ducnguyen1224/HARD_WARE_SFAM/SensorNode_180808/BOM/SensorNode.xlsx

Sheet: SensorNode
DANH SÁCH LINH KIỆN MẠCH SENSOR
STT | Comment | Description | Designator | Số lượng trên mạch | Digikey Part Number hoặc Link mua hàng tại Việt Nam
1 | 0.1µF | CAP CER 0.1UF 10V X7R 0402 | C1, C2, C5, C6, C7, C8, C9, C10, C11, C12, C13, C14, C15, C16, C17, C18, C19, C20, C21, C22, C23, C24, C25, C26 | 24 | GRM155R61C104KA88D
2 | 10µF | CAP CER 10UF 16V X7R 0805 | C3, C4 | 2 | C2012X5R1C106K085AC
3 | Header 11 | MicroSD Card TF V3 Connector | J1 | 1 | http://banlinhkien.vn/goods-1914-socket-microsd-tf-v3-socket-the-nho-.html
4 | Ferrite Bead | FERRITE BEAD 42 OHM 0805 1LN | L1 | 1 | FBMJ2125HS420-T
5 | LedRed0603 | LED RED CLEAR 0603 SMD | LED1 | 1 | http://banlinhkien.vn/goods-2338-led-0603-mau-do-red-.html
6 | LedGreen0603 | LED GREEN CLEAR 0603 SMD | LED2 | 1 | http://banlinhkien.vn/goods-2945-led-0603-mau-xanh-la-green-.html
7 | Header 2 | Header, 2-Pin | P1, P10 | 2 | http://banlinhkien.vn/goods-987-con-2-kf301-2p-5-08mm-xanh-duong.html
8 | Header 4X2H | Header, 4-Pin, Dual row, Right Angle | P2 | 1 | http://banlinhkien.vn/goods-2686-jump-doi-duc-2-54mm-2x40p-thang-11mm.html
9 | Header 4H | TERM BLOCK PLUG 4POS STR 5.08MM | P3, P6 | 2 | http://banlinhkien.vn/goods-979-con-4-2edg5-08-4p-5-08mm-xanh-cong-.html
10 | BNC connector |  | P4, P5, P8, P9 | 4 | http://thegioiic.com/products/fm-bnc-v1
11 | Header 5 | TERM BLOCK PLUG 5POS STR 5.08MM (Ghép CON3 và CON2 lại) | P7 | 1 | http://banlinhkien.vn/goods-986-con-3-kf301-3p-5-08mm-xanh-duong.html http://banlinhkien.vn/goods-987-con-2-kf301-2p-5-08mm-xanh-duong.html
12 | Header 3 | Header, 3-Pin | P11 | 1 | http://banlinhkien.vn/goods-3526-jump-don-duc-led-1x40p.html
13 | Header 3X2 | Header, 3-Pin, Dual row | P12 | 1 | http://banlinhkien.vn/goods-2686-jump-doi-duc-2-54mm-2x40p-thang-11mm.html
14 | AO3401 | P-Channel MOSFET | Q1, Q2, Q3, Q4, Q5 | 5 | http://banlinhkien.vn/goods-5697-2n5551-sot23-trans-npn-0-6a-160v-100mhz-g1-.html
15 | 0 | RES SMD 0.0 OHM JUMPER 1/8W 0805 | R1, R2, R4, R13 | 4 | ERJ-6GEY0R00V
16 | 1.5k | RES SMD 1.5K OHM 1% 1/10W 0603 | R3 | 1 | ERA-3AEB152V
17 | 1k | RES SMD 1K OHM 1% 1/10W 0603 | R5, R14 | 2 | ERA-3AEB102V
18 | 10k | RES SMD 10K OHM 1% 1/10W 0603 | R6, R7, R8, R9, R10, R11, R12, R15, R18, R19, R20, R21, R22 | 13 | ERA-3AEB103V
19 | 187k | RES SMD 187K OHM 1% 1/10W 0603 | R16 | 1 | ERA-3AEB1873V
20 | 182k | RES SMD 182K OHM 1% 1/10W 0603 | R17 | 1 | ERA-3AEB1823V
21 | Button | Nút nhấn | RST1 | 1 | http://banlinhkien.vn/goods-1036-nut-nhan-2-chan-3x6x2-5mm-smd.html
22 | SMBJ7.0A | TVS DIODE 7V 12V DO214AA | TVS1 | 1 | SMBJ7.0A
23 | TPS7A7100 | IC REG LDO FIX/ADJ 1A 16QFN | U1 | 1 | TPS7A7100
24 | MK64FN1M0VLL12 | IC MCU 32BIT 1MB FLASH 100LQFP | U2 | 1 | MK64FN1M0VLL12
25 | TPL5010-Q1 | IC TIMER W/WATCHDOG 6SOT | U3 | 1 | TPL5010QDDCRQ1
26 | pH AFE | pH AFE | U4, U5, U6, U7 | 4 | Đây là mục EZO
27 | VZIGMOD1 | VNPT ZIGBEE MODULE V1 - No-PA | U8 | 1 | https://www.alibaba.com/product-detail/CC2538-CC2592-zigbee-radio-module_60620989315.html
28 | Antenna | 2.4GHz Antenna |  | 1 | http://banlinhkien.vn/goods-8260-anten-wifi-2-4g-2dbi-ipex-aw-2-4g-2ip.html

Sheet: banlinhkien.vn
STT | Link | Số lượng
1 | http://banlinhkien.vn/goods-2338-led-0603-mau-do-red-.html | 5
2 | http://banlinhkien.vn/goods-2945-led-0603-mau-xanh-la-green-.html | 5
3 | http://banlinhkien.vn/goods-1720-jump-doi-duc-1-27mm-2x40p-thang.html | 1
4 | http://banlinhkien.vn/goods-979-con-4-2edg5-08-4p-5-08mm-xanh-cong-.html | 5
5 | http://banlinhkien.vn/goods-986-con-3-kf301-3p-5-08mm-xanh-duong.html | 10
6 | http://banlinhkien.vn/goods-987-con-2-kf301-2p-5-08mm-xanh-duong.html | 10
7 | http://banlinhkien.vn/goods-3526-jump-don-duc-led-1x40p.html | 2
8 | http://banlinhkien.vn/goods-5697-2n5551-sot23-trans-npn-0-6a-160v-100mhz-g1-.html | 20
9 | http://banlinhkien.vn/goods-5061-module-wifi-esp8266-esp-12e.html | 2
10 | http://banlinhkien.vn/goods-7501-nut-nhan-4-chan-6x6x5mm-smd.html | 5
