ducnguyen1224/HARD_WARE_SFAM/Sfarm _GW/BOM/GWSfarm.xlsx

Designator | Description | Manufacturer | Manufacturer Part Number | Quantity/Product | Link
BT200, BT201 | Nút Nhấn 2 Chân 3x6x2.5MM SMD |  |  | 10 | http://banlinhkien.vn/goods-1036-nut-nhan-2-chan-3x6x2-5mm-smd.html
C10, C100, C101, C104, C105, C115, C200, C201, C202, C203, C205, C206, C208, C209, C210, C211, C212, C213, C400 | CAP CER 0.1UF 10V X7R 0402 | Taiyo Yuden | LMK105B7104KVHF | 18 | https://www.digikey.com/product-detail/en/taiyo-yuden/LMK105B7104KVHF/587-3769-1-ND/4811239
C102, C103 | CAP CER 10UF 16V X7R 0805 | Taiyo Yuden | EMK212BB7106MG-T | 2 | https://www.digikey.com/product-detail/en/taiyo-yuden/EMK212BB7106MG-T/587-3319-1-ND/4157364
C106, C114 | CAP CER 2.2UF 16V X5R 0402 | Taiyo Yuden | EMK105ABJ225MV-F | 2 | https://www.digikey.com/product-detail/en/taiyo-yuden/EMK105ABJ225MV-F/587-3302-1-ND/4157199
C107, C108, C109, C110, C111, C112 | CAP CER 22UF 16V X5R 0805 | Taiyo Yuden | EMK212BBJ226MG-T | 6 | https://www.digikey.com/product-detail/en/taiyo-yuden/EMK212BBJ226MG-T/587-3239-1-ND/3660095
C113 | CAP TANT 150UF 10V 10% 2917 | AVX Corporation | TPSD157K010R0085 | 1 | https://www.digikey.com/product-detail/en/avx-corporation/TPSD157K010R0085/478-9158-1-ND/4562023
C204, C207 | CAP CER 12PF 50V C0G/NP0 0402 | Murata Electronics North America | GRM1555C1H120GA01D | 2 | https://www.digikey.com/product-detail/en/murata-electronics-north-america/GRM1555C1H120GA01D/490-6197-1-ND/3845394
D100 | TVS DIODE 7V 12V DO214AA | Littelfuse Inc | SMBJ7.0A | 1 | https://www.digikey.com/product-detail/en/littelfuse-inc/SMBJ7.0A/SMBJ7.0ALFDKR-ND/741878
L101 | Fixed Inductors 1uH 20% 11A 11.9mOhms AEC-Q200 | Coilcraft | XFL4020-102MEB | 1 | https://www.mouser.vn/ProductDetail/Coilcraft/XFL4020-102MEB
P100 | CON 2 KF301-2P 5.08MM Xanh Dương |  |  | 1 | http://banlinhkien.vn/goods-987-con-2-kf301-2p-5-08mm-xanh-duong.html
P200 | Jump Đôi Đực 2.54MM 2x40P Thẳng 11MM |  |  | 1 | http://banlinhkien.vn/goods-2686-jump-doi-duc-2-54mm-2x40p-thang-11mm.html
P201 | Socket MicroSD TF V3 (Socket Thẻ Nhớ) |  |  | 1 | http://banlinhkien.vn/goods-1914-socket-microsd-tf-v3-socket-the-nho-.html
P400, P401 | Jump Đôi Đực 2.54MM 2x40P Cong |  |  | 2 | http://banlinhkien.vn/goods-5385-jump-doi-duc-2-54mm-2x40p-cong.html
P402, P404 | Header, 3-Pin |  |  | 2 | http://banlinhkien.vn/goods-903-jump-don-duc-2-54mm-1x40p-thang-11mm.html
PWR | LED RED CLEAR 0603 SMD | Everlight Electronics Co Ltd | QTLP600C7TR | 1 | http://banlinhkien.vn/goods-2338-led-0603-mau-do-red-.html
Q400 | MOSFET P-1CH 4A 30V (A19T) |  | AO3401 | 1 | http://banlinhkien.vn/goods-5697-ao3401-sot23-3-mosfet-p-1ch-4a-30v-a19t-.html
R100, L100, L102 | RES SMD 0.0 OHM JUMPER 1/8W 0805 | Panasonic Electronic Components | ERJ-6GEY0R00V | 3 | https://www.digikey.com/product-detail/en/panasonic-electronic-components/ERJ-6GEY0R00V/P0.0ADKR-ND/577786
R101 | RES SMD 1.5K OHM 1% 1/10W 0603 | Panasonic Electronic Components | ERJ-3EKF1501V | 1 | https://www.digikey.com/product-detail/en/panasonic-electronic-components/ERJ-3EKF1501V/P1.50KHDKR-ND/576003
R103, R208 | RES SMD 1K OHM 1% 1/10W 0603 | Panasonic Electronic Components | ERJ-3EKF1001V | 2 | https://www.digikey.com/product-detail/en/panasonic-electronic-components/ERJ-3EKF1001V/P1.00KHDKR-ND/575914
R104 | RES SMD 1M OHM 1% 1/10W 0402 | Yageo | RC0402FR-071ML | 1 | https://www.digikey.com/product-detail/en/yageo/RC0402FR-071ML/311-1.00MLRDKR-ND/732409
R106 | RES SMD 1M OHM 1% 1/10W 0603 | Panasonic Electronic Components | RC0603FR-071ML | 1 | https://www.digikey.com/product-detail/en/yageo/RC0603FR-071ML/311-1.00MHRDKR-ND/732738
R107 | RES SMD 150K OHM 1% 1/10W 0402 | Panasonic Electronic Components | ERJ-2RKF1503X | 1 | https://www.digikey.com/product-detail/en/panasonic-electronic-components/ERJ-2RKF1503X/P150KLDKR-ND/575521
R108, R109 | RES SMD 47K OHM 1% 1/10W 0603 | Panasonic Electronic Components | ERJ-3EKF4702V | 2 | https://www.digikey.com/product-detail/en/panasonic-electronic-components/ERJ-3EKF4702V/P47.0KHDKR-ND/1747145
R200, R202, R209, R400, R401, R404 | RES SMD 10K OHM 1% 1/10W 0603 | Panasonic Electronic Components | ERJ-3EKF1002V | 6 | https://www.digikey.com/product-detail/en/panasonic-electronic-components/ERJ-3EKF1002V/P10.0KHDKR-ND/575915
R207, R212 | RES SMD 0.0OHM JUMPER 1/10W 0603 | Panasonic Electronic Components | ERJ-3GEY0R00V | 2 | https://www.digikey.com/product-detail/en/panasonic-electronic-components/ERJ-3GEY0R00V/P0.0GDKR-ND/577612
R210 | RES SMD 33K OHM 0.1% 1/10W 0603 | Yageo | RT0603BRD0733KL | 1 | https://www.digikey.com/product-detail/en/yageo/RT0603BRD0733KL/YAG1640DKR-ND/5140017
STT | LED GREEN CLEAR 0603 SMD | Everlight Electronics Co Ltd | QTLP601C4TR | 1 | http://banlinhkien.vn/goods-2945-led-0603-mau-xanh-la-green-.html
U100 | IC REG LDO FIX/ADJ 1A 16QFN | Texas Instruments | TPS7A7100RGTR | 1 | https://www.digikey.com/product-detail/en/texas-instruments/TPS7A7100RGTR/296-40978-6-ND/5180088
U101 | IC REG BUCK BST ADJ 3.5A | Texas Instruments | TPS63020QDSJRQ1 | 1 | https://www.digikey.com/product-detail/en/texas-instruments/TPS63020QDSJRQ1/296-43286-6-ND/5801594
U200 | IC MCU 32BIT 1MB FLASH 100LQFP | NXP USA Inc. | MK64FN1M0VLL12 | 1 | https://www.digikey.com/product-detail/en/nxp-usa-inc/MK64FN1M0VLL12/MK64FN1M0VLL12-ND/4462052
U202 | IC TIMER W/WATCHDOG 6SOT | Texas Instruments | TPL5010QDDCRQ1 | 1 | https://www.digikey.com/product-detail/en/texas-instruments/TPL5010QDDCRQ1/296-44963-6-ND/6235576
Y200 | CRYSTAL 32.7680KHZ 12.5PF SMD | Abracon LLC | ABS07-32.768KHZ-T | 1 | https://www.digikey.com/product-detail/en/abracon-llc/ABS07-32.768KHZ-T/535-9542-6-ND/1624263
U400 | Jump Đôi Cái 1.27MM 2x40P Dán |  |  | 1 | http://banlinhkien.vn/goods-1724-jump-doi-cai-1-27mm-2x40p-dan.html
U8 | Zigbee module |  |  | 1 | https://www.alibaba.com/product-detail/CC2538-CC2592-zigbee-radio-module_60620989315.html
 | Module 3G | SIMCOM | sim 5360e | 1 | https://item.taobao.com/item.htm?id=39659918639&ns=1&abbucket=11 (https://item.taobao.com/item.htm?spm=a230r.1.14.33.269431b1O0DzLh&id=39659918639&ns=1&abbucket=11)
 | Dây nối dài anten SMA đực - Ipex |  |  | 1 | http://banlinhkien.vn/goods-1825-day-keo-dai-anten-sim-sma-cai-u-fl-mmcx-sma-rf-sma-.html
 | Anten 3G SMA cái |  |  | 1 | http://banlinhkien.vn/goods-1827-anten-sim-sma-duc-chan-cong.html
