ducnguyen1224/HARD_WARE_SFAM/WiFi_Shield_180808/WiFi_Shield_180808/BOM/WiFi_Shield.xlsx

Comment | Description | Designator | Số lượng trên mạch | Digikey Part Number hoặc Link mua tại Việt Nam
0.1µF | CAP CER 0.1UF 10V X7R 0402 | C1, C3, C4 | 3 | GRM155R61C104KA88D
10µF | CAP CER 10UF 10V X5R 0603 | C2 | 1 | C2012X5R1C106K085AC
Header 4 | Header, 4-Pin | P2 | 1 | http://banlinhkien.vn/goods-903-jump-don-duc-2-54mm-1x40p-thang-11mm.html
Header 3 | Header, 3-Pin | P3 | 1
MHDR2X10 | Header, 10-Pin, Dual row | P4 | 1 | http://banlinhkien.vn/goods-1721-jump-doi-duc-1-27mm-2x40p-dan.html
AO3401 | P-Channel MOSFET | Q1 | 1 | http://banlinhkien.vn/goods-5697-2n5551-sot23-trans-npn-0-6a-160v-100mhz-g1-.html
10k | RES SMD 10K OHM 1% 1/16W 0402 | R1, R2, R3, R4, R5, R6, R8, R10 | 8 | ERA-3AEB103V
RS-282G05A3-SM RT | SWITCH TACTILE SPST-NO 0.05A 12V | S1 | 1 | http://banlinhkien.vn/goods-1036-nut-nhan-2-chan-3x6x2-5mm-smd.html
PTS645SL70SMTR92LFS | SWITCH TACTILE SPST-NO 0.05A 12V | SW1 | 1 | PTS645SL70SMTR92LFS
ESP-12e | ESP8266 SMT MODULE | U1 | 1 | http://thegioiic.com/products/esp-12f-esp8266-mach-thu-phat-wifi
