ducnguyen1224/HARD_WARE_SFAM/SensorNode_180808/PDF/Schematic Prints.PDF

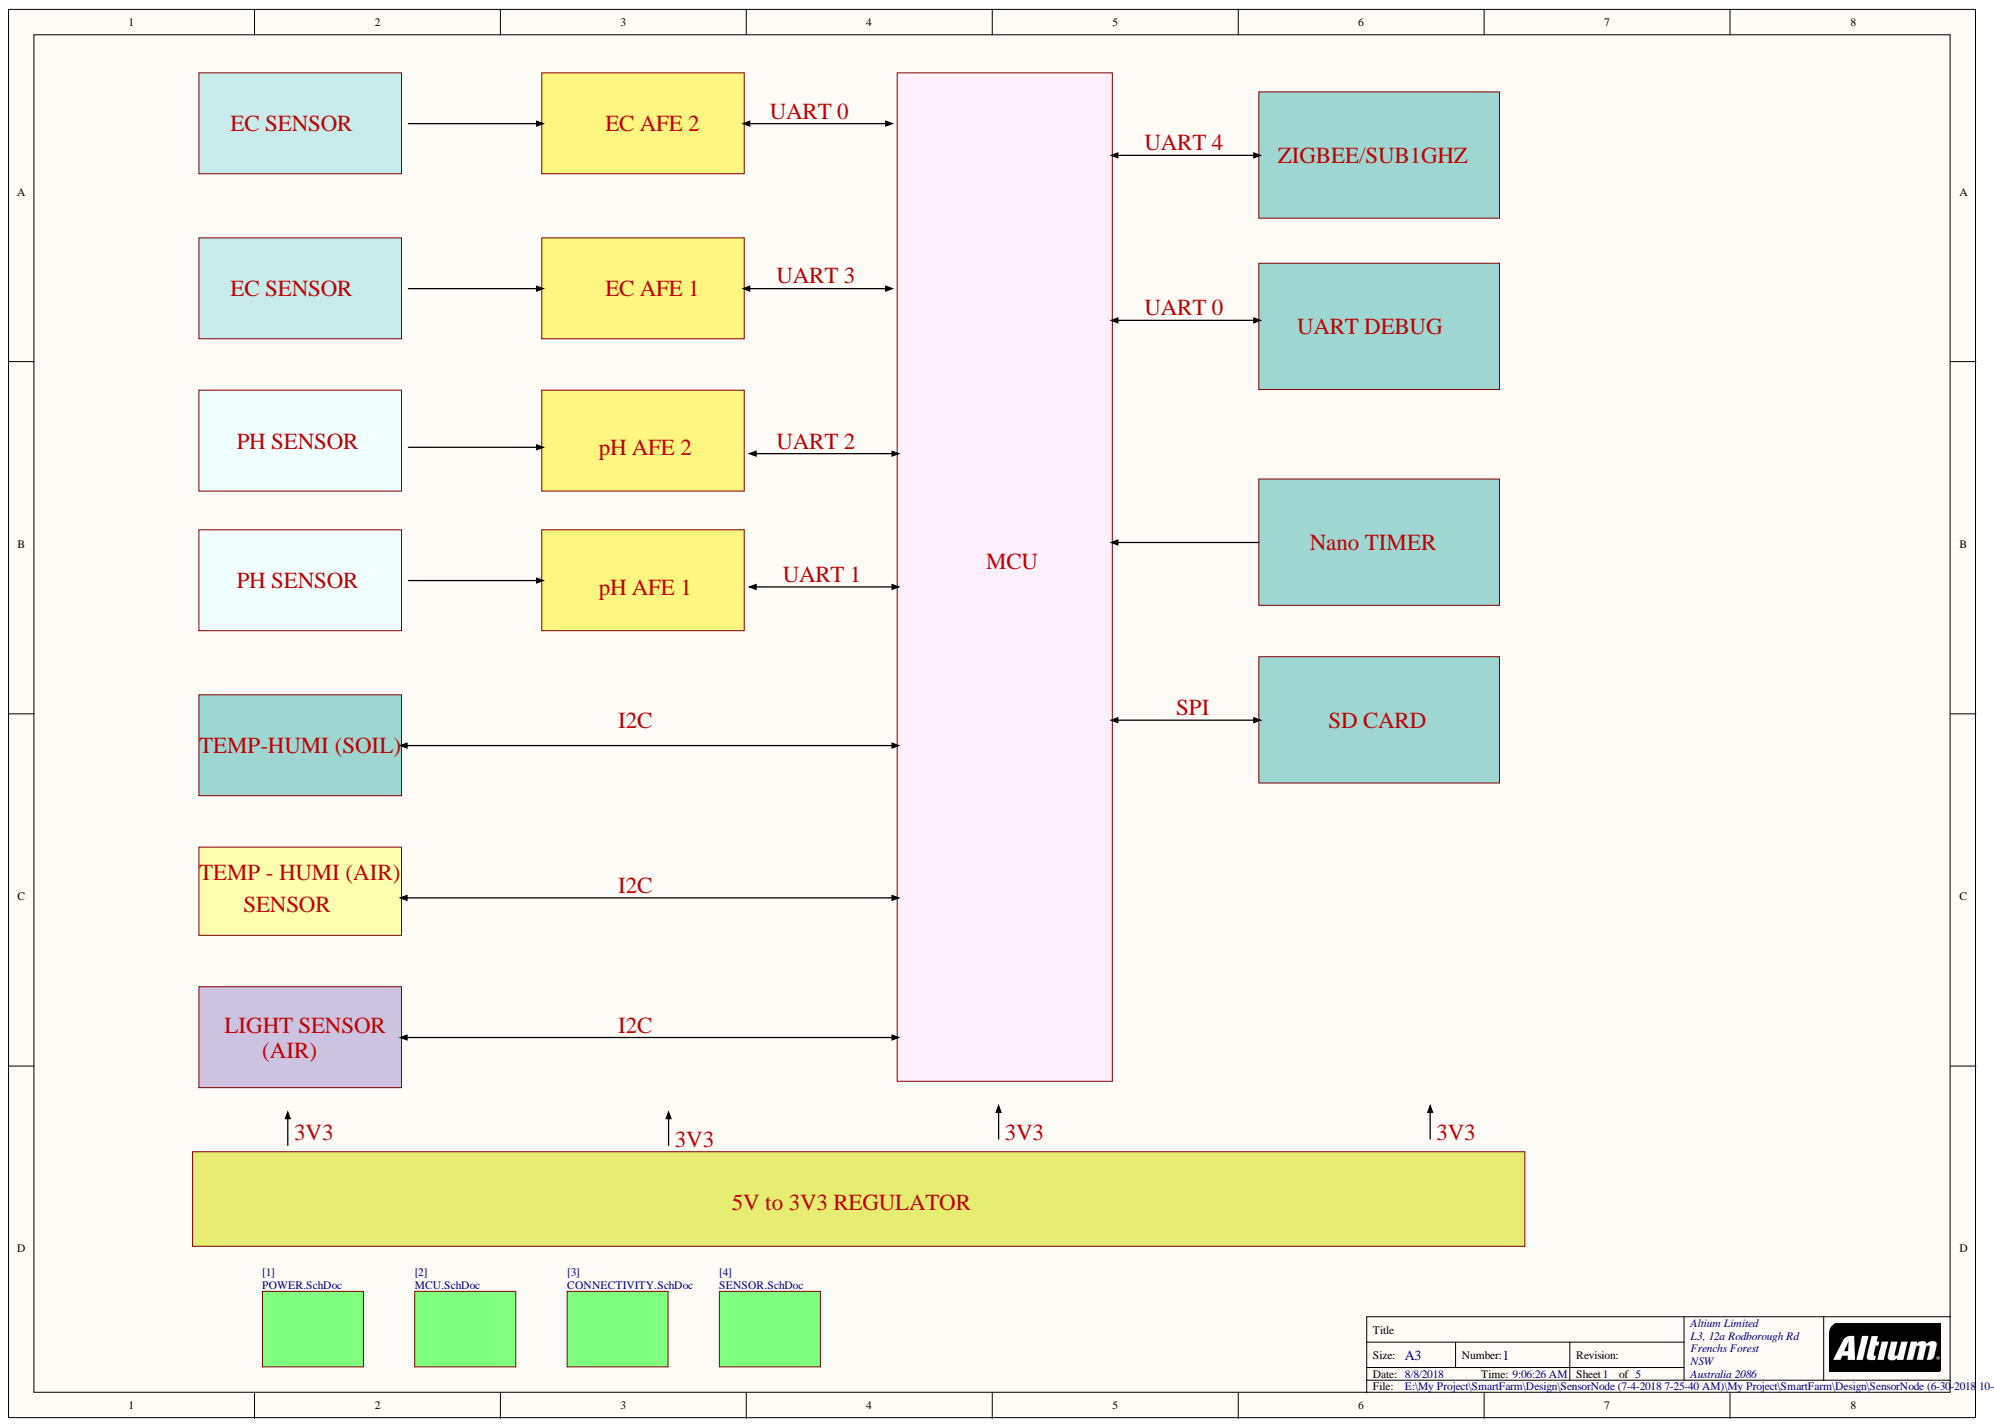
[picture p1: page 1]

pH AFE 2 PH SENSOR

Title | Altium Limited L3, 12a Rodborough Rd Frenchs Forest NSW Australia 2086

Size: A3 | Number: | Revision:

Date: 8/8/2018 Time: 9:06:26 AM | | Sheet of 5

E:\My Project\SmartFarm\Design\SensorNode (7-4-2018 7-25-40 AM)\My Project\SmartFarm\Design\SensorNode (6-30-2018 10-46-34 PM)\BLOCK DIAGRAM.SchDoc

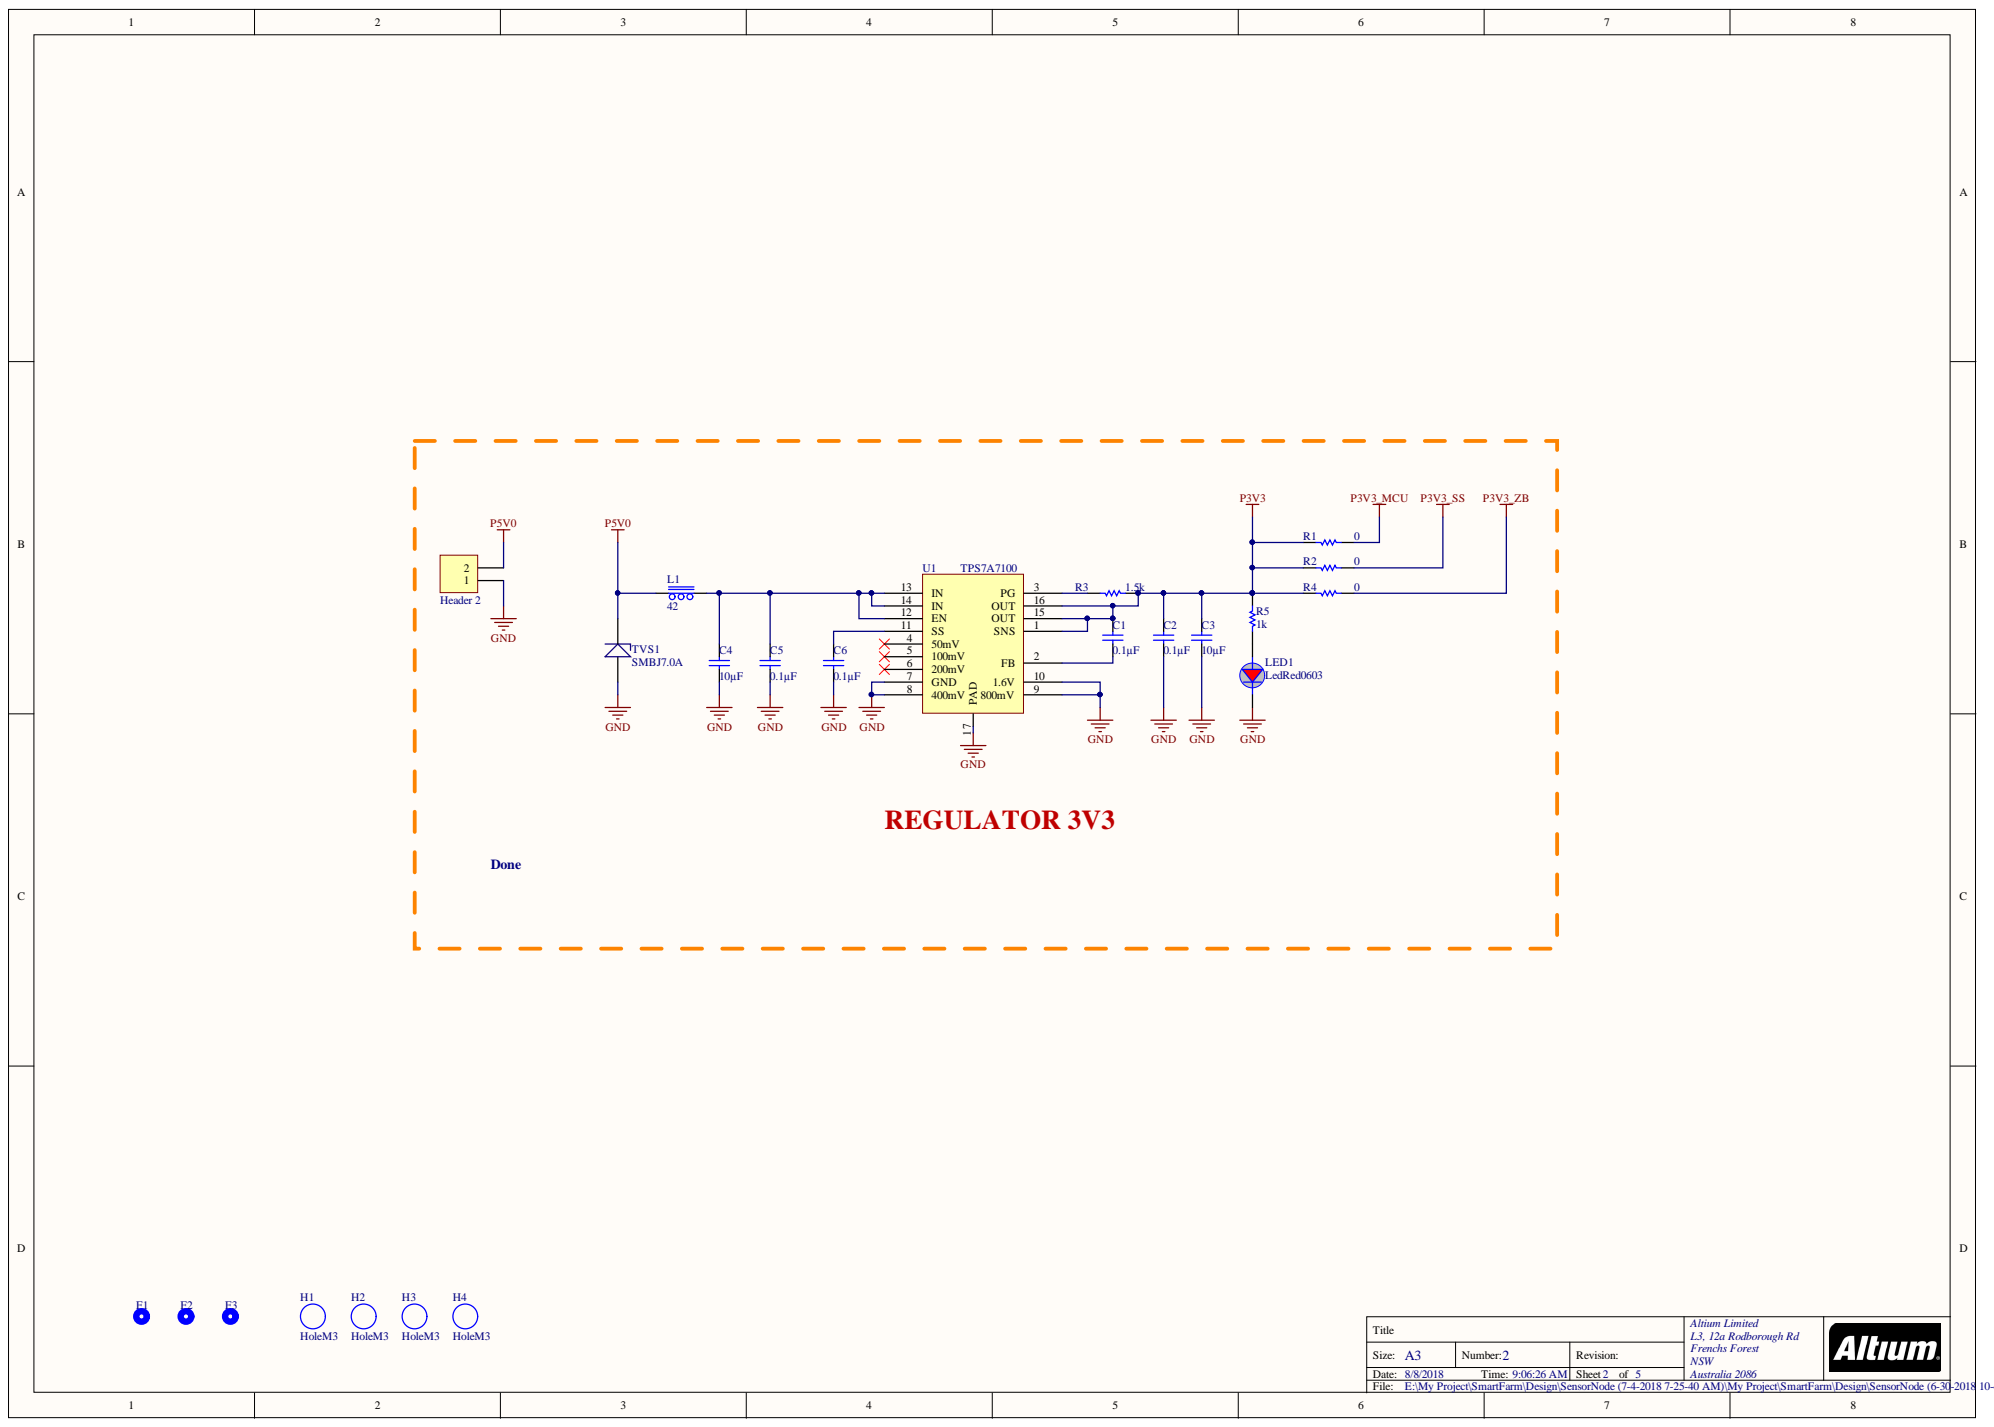
[picture p2: page 2]

E:\My Project\SmartFarm\Design\SensorNode (7-4-2018 7-25-40 AM)\My Project\SmartFarm\Design\SensorNode (6-30-2018 10-46-34 PM)\POWER.SchDoc

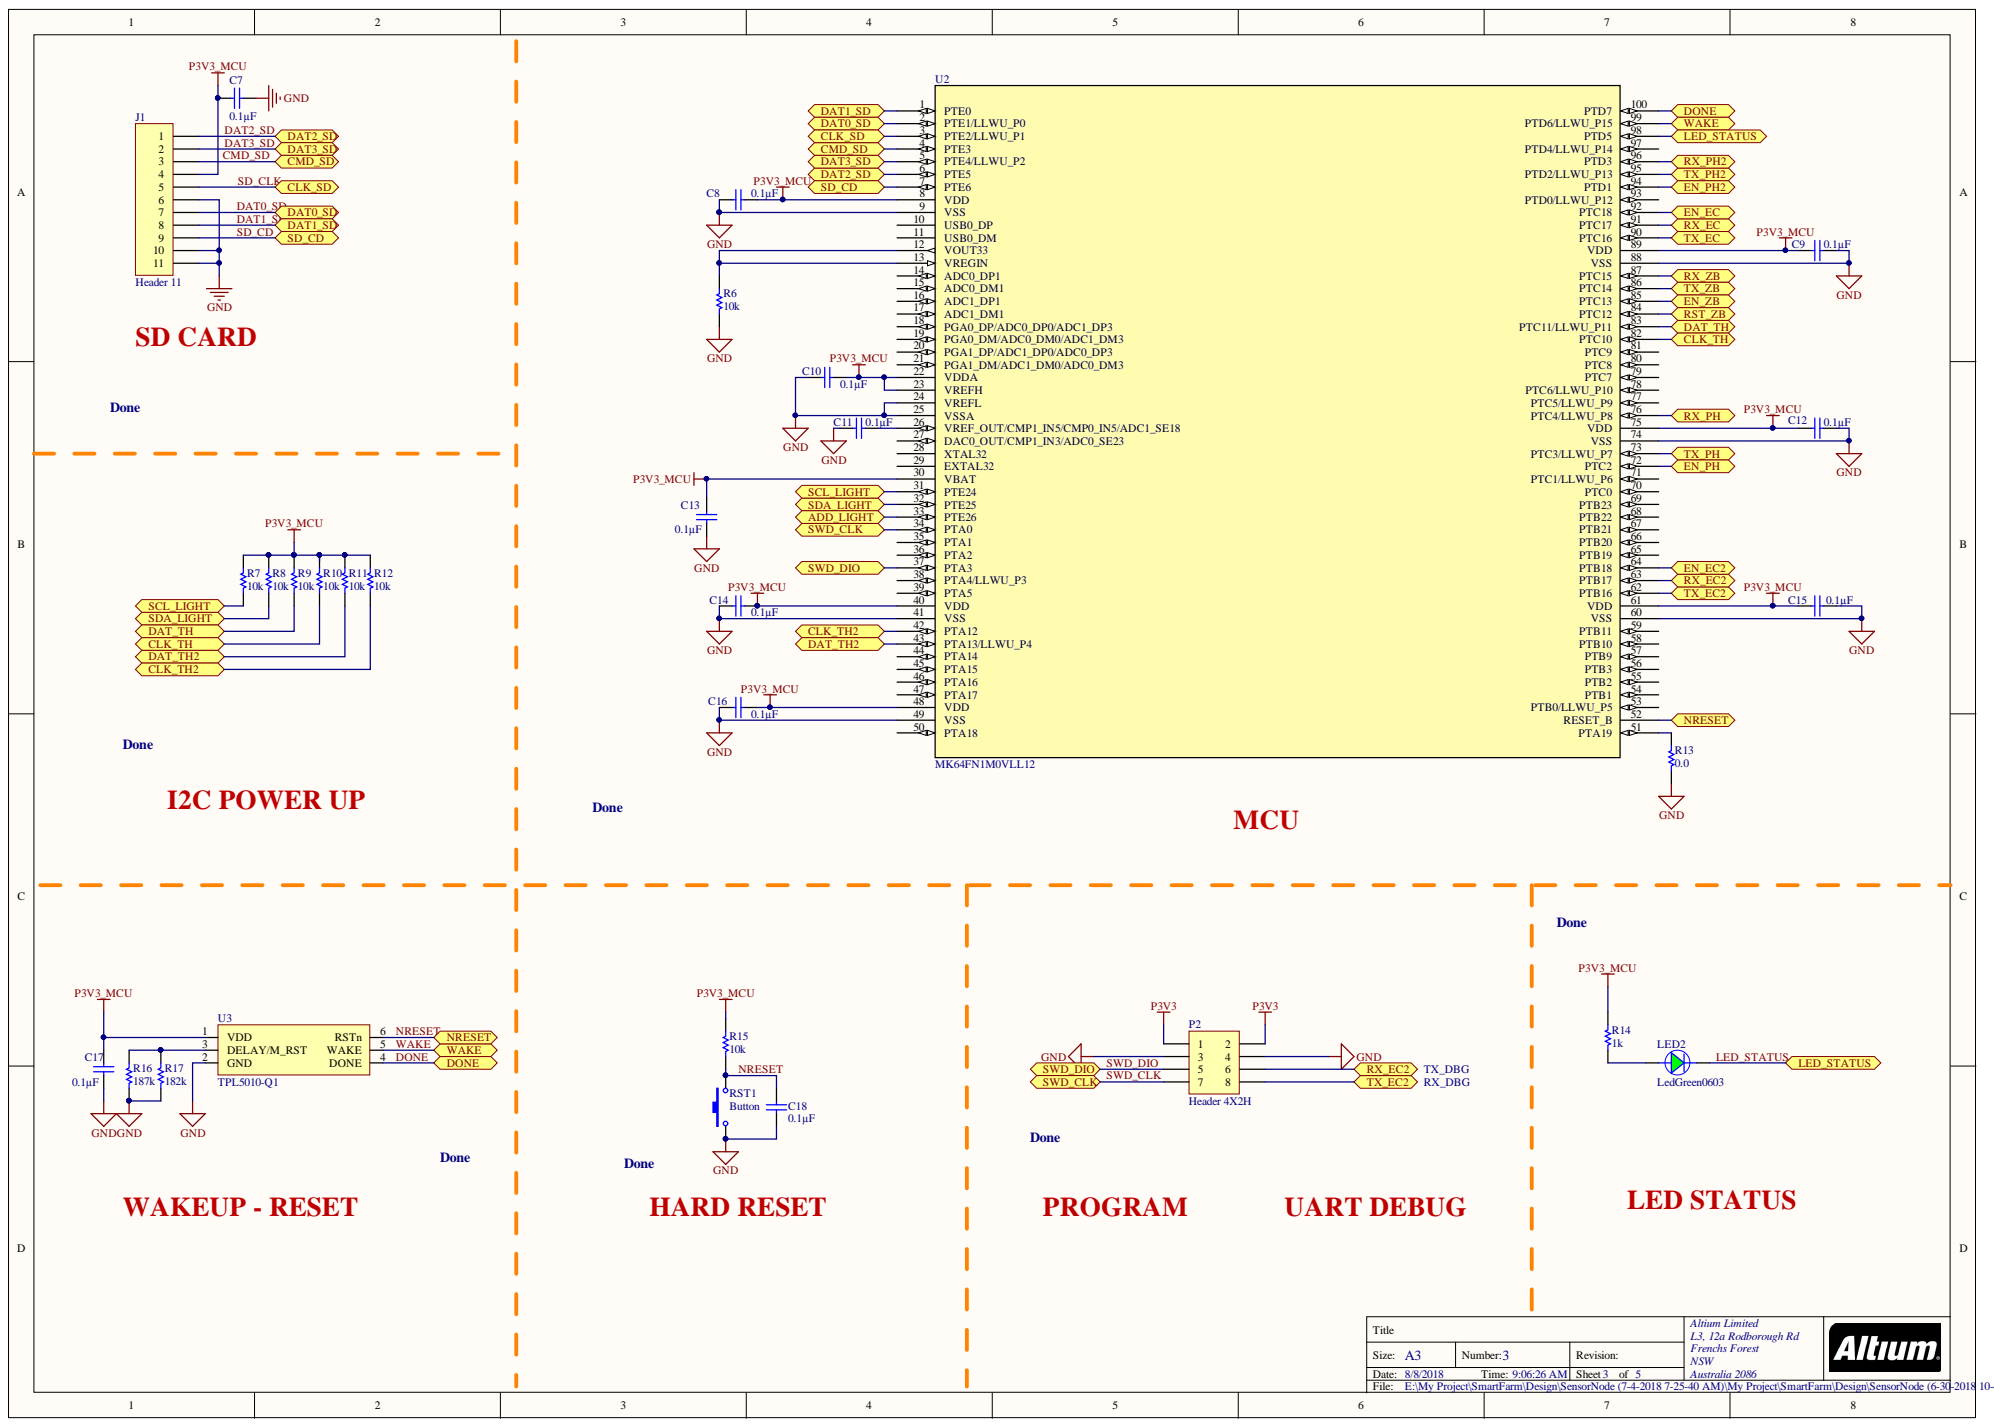
[picture p3: page 3]

VREFH 23

VSSA 25

E:\My Project\SmartFarm\Design\SensorNode (7-4-2018 7-25-40 AM)\My Project\SmartFarm\Design\SensorNode (6-30-2018 10-46-34 PM)\MCU.SchDoc

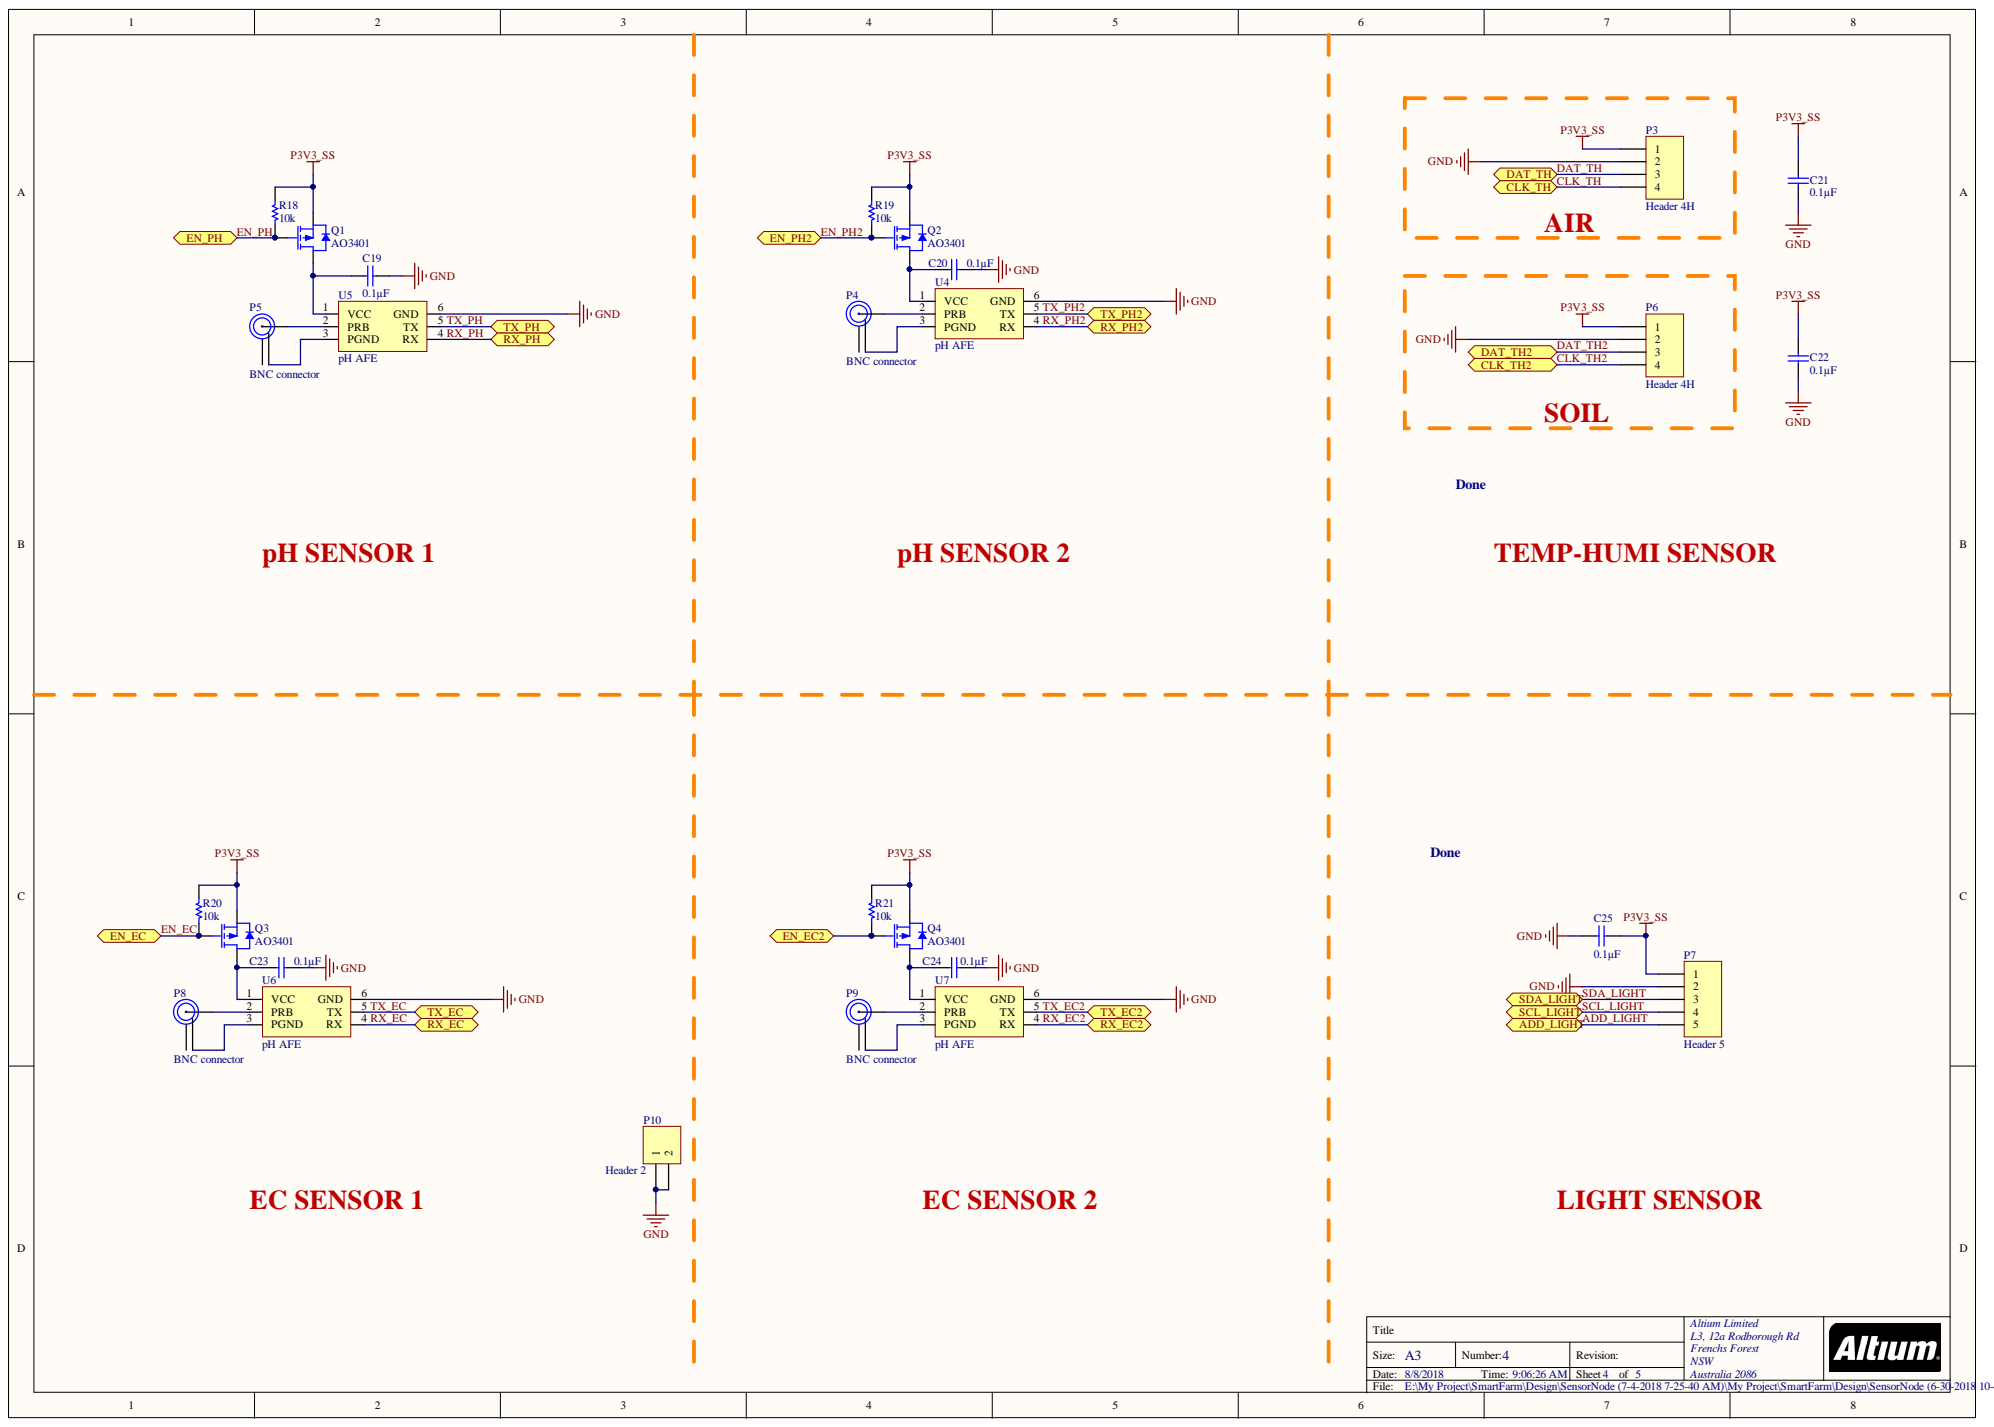
[picture p4: page 4]

E:\My Project\SmartFarm\Design\SensorNode (7-4-2018 7-25-40 AM)\My Project\SmartFarm\Design\SensorNode (6-30-2018 10-46-34 PM)\SENSOR.SchDoc

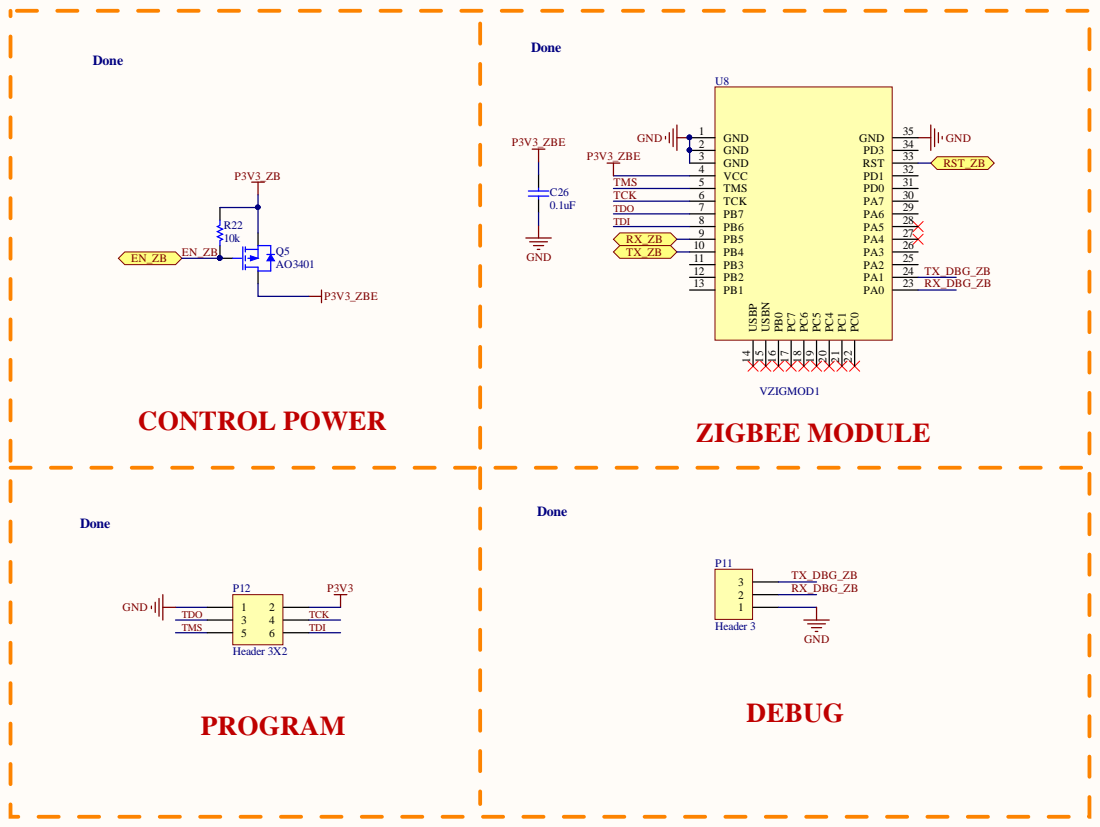
[picture p5: page 5]

E:\My Project\SmartFarm\Design\SensorNode (7-4-2018 7-25-40 AM)\My Project\SmartFarm\Design\SensorNode (6-30-2018 10-46-34 PM)\CONNECTIVITY.SchDoc
