ducnguyen1224/HARD_WARE_SFAM/WiFi_Shield_180808/WiFi_Shield_180808/PDF/Schematic Prints.PDF

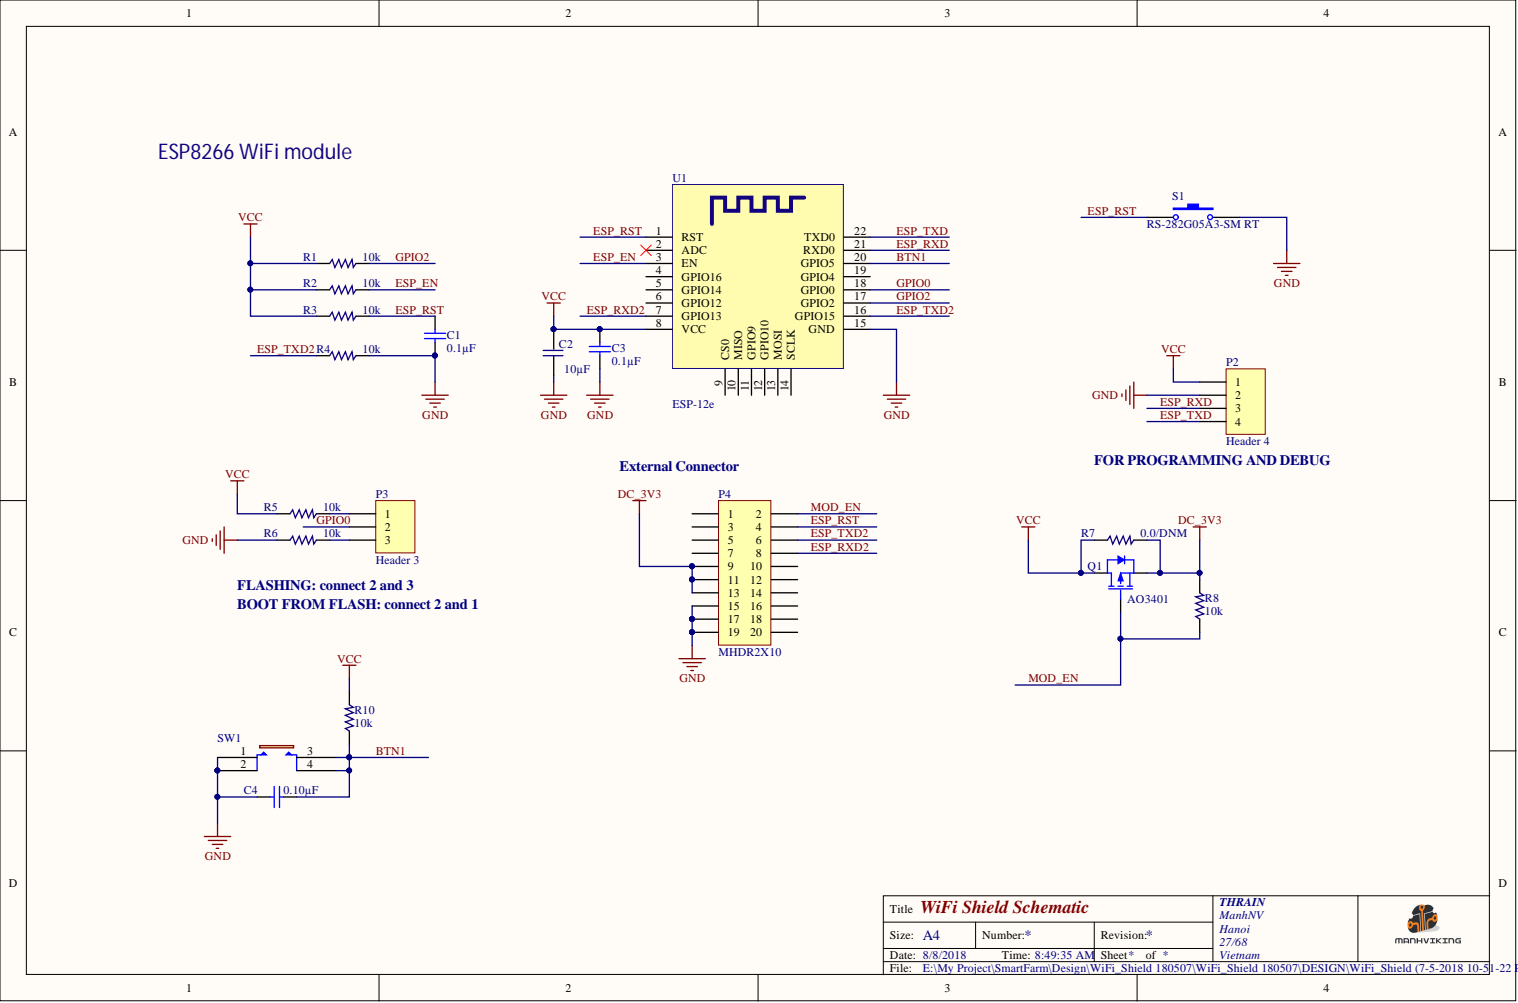
[picture p6: page 1]

FOR PROGRAMMING AND DEBUG

FLASHING: connect 2 and 3
BOOT FROM FLASH: connect 2 and 1

Title WiFi Shield Schematic | THRAIN ManhNV Hanoi 27/68 Vietnam

Size: A4 | Number: * | Revision: *
Date: 8/8/2018 Time: 8:49:35 AM | | Sheet * of *

E:\My Project\SmartFarm\Design\WiFi_Shield 180507\WiFi_Shield 180507\DESIGN\WiFi_Shield (7-5-2018 10-51-22 PM)\Smart Farm\Design\WiFi_Shield\WiFi Shield Schematic.SchDoc
