ducnguyen1224/HARD_WARE_SFAM/SensorNode_180808/PDF/Assembly Guideline.PDF

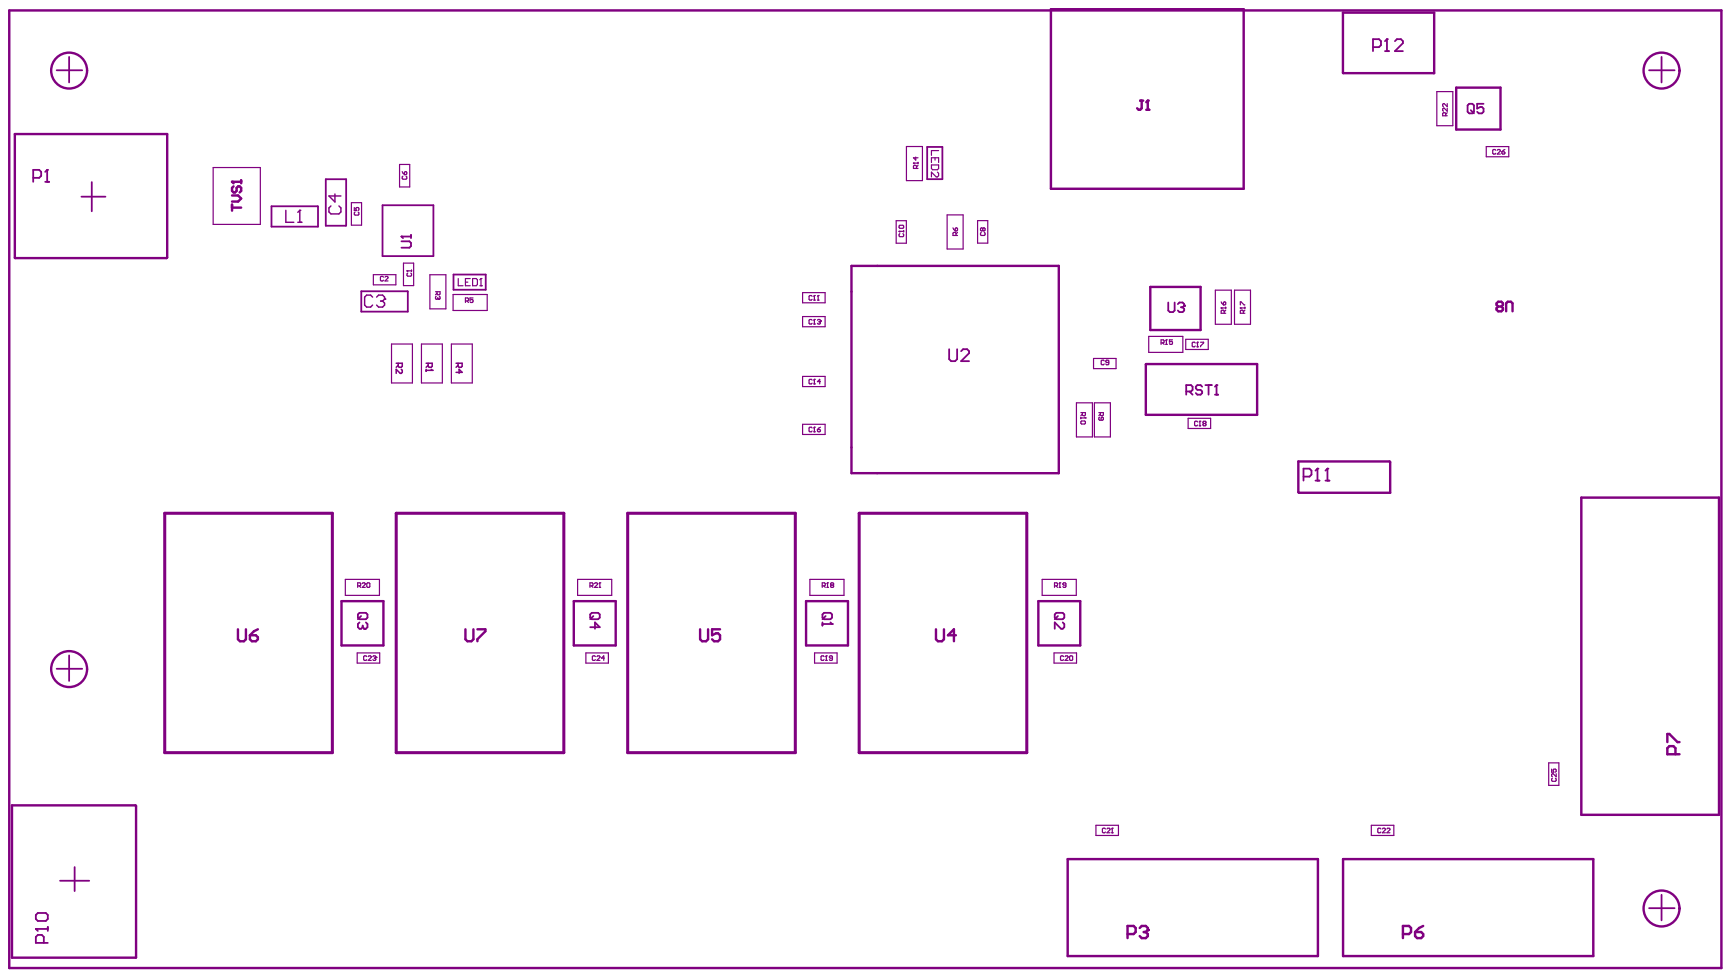
[picture p7: page 1]

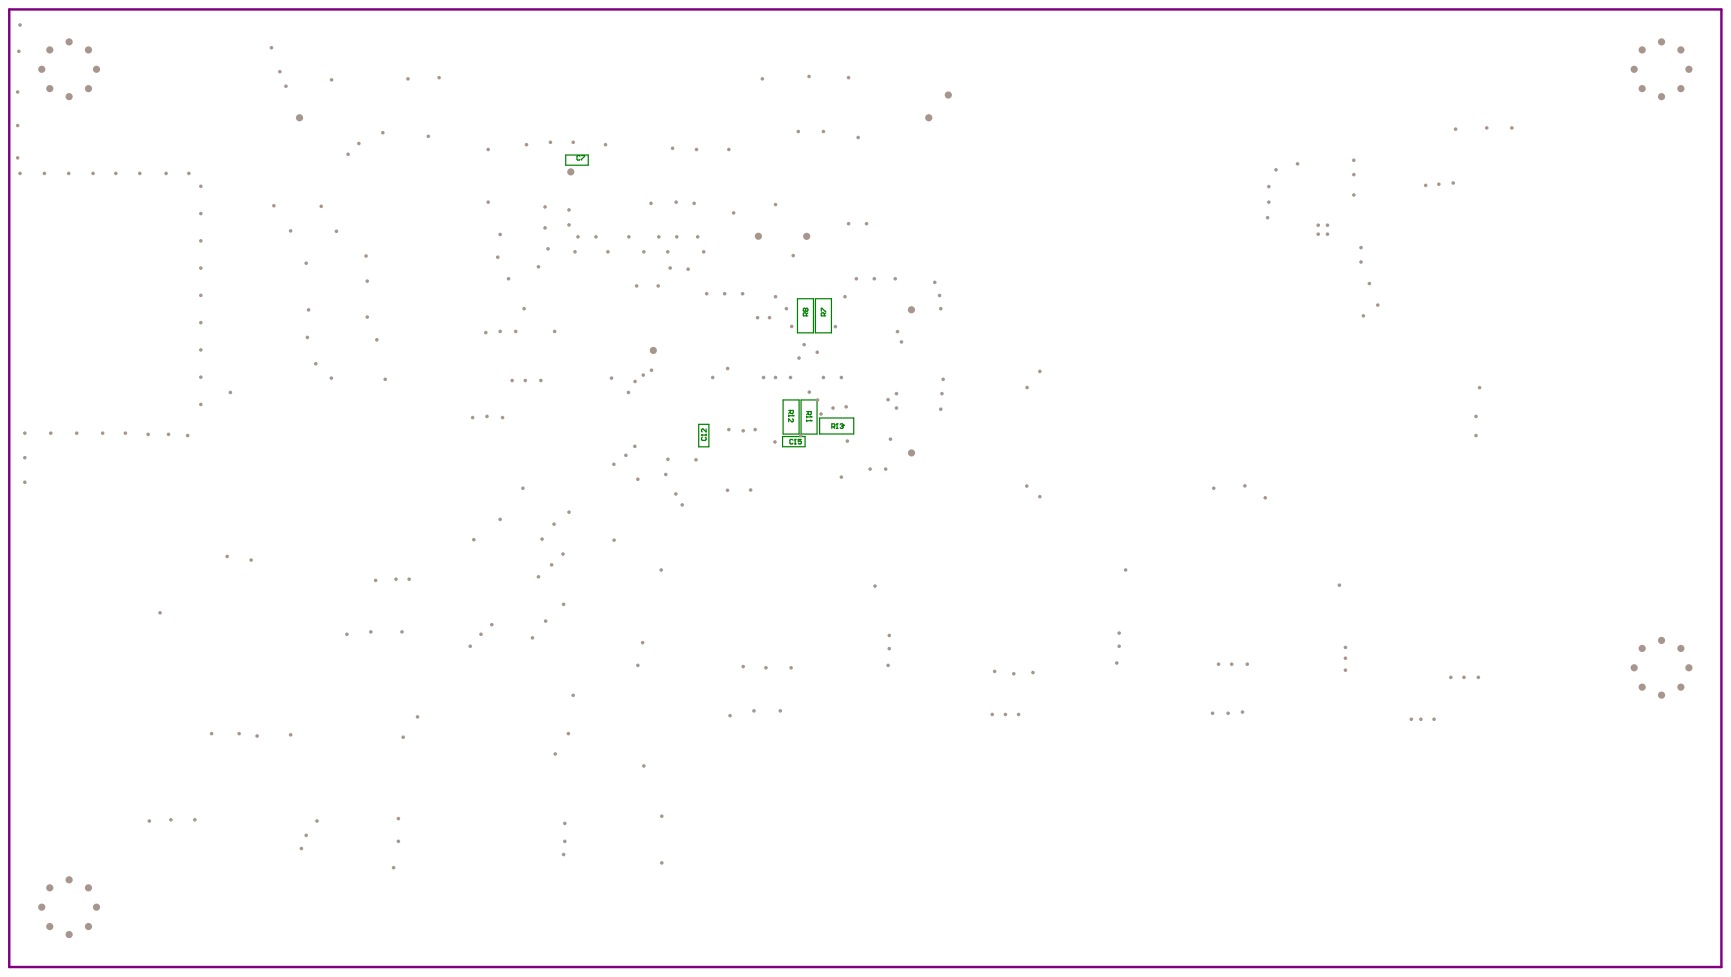
[picture p8: page 2]
