ducnguyen1224/HARD_WARE_SFAM/SensorNode_180808/PDF/PCB 3D Print BOT.PDF

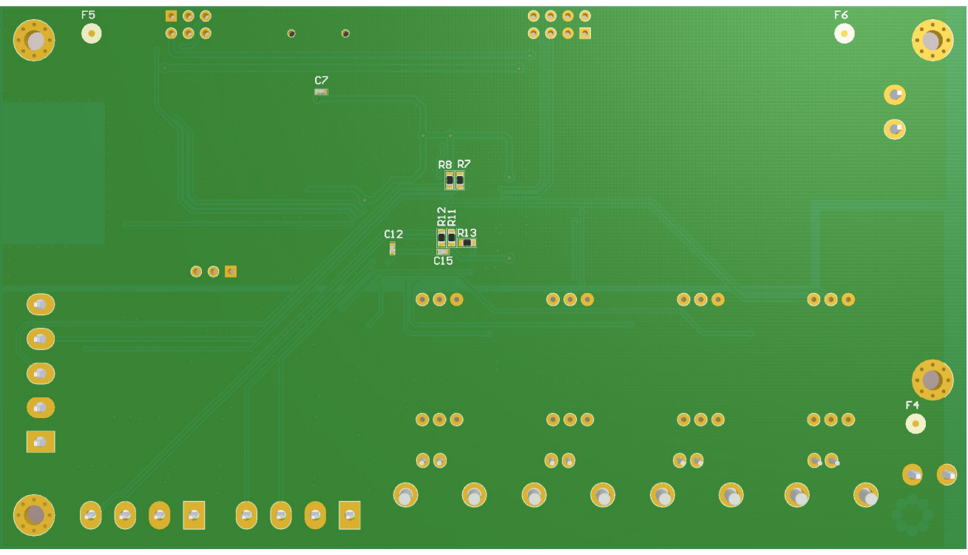
[picture p9: page 1]
