ducnguyen1224/HARD_WARE_SFAM/SensorNode_180808/PDF/PCB 3D Print TOP.PDF

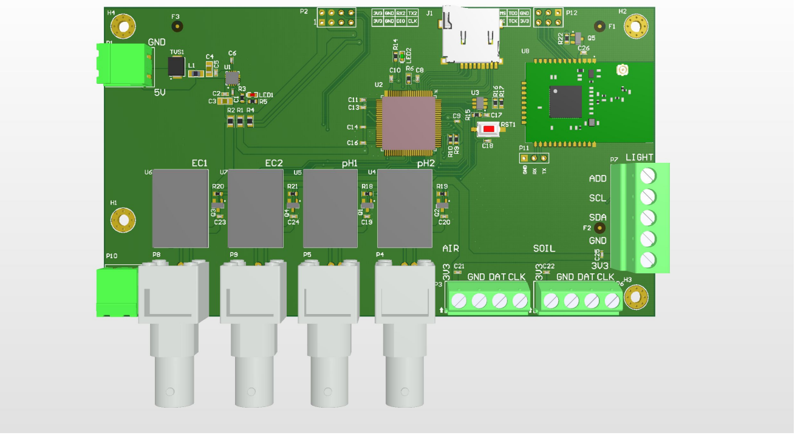
[picture p10: page 1]
