ducnguyen1224/HARD_WARE_SFAM/WiFi_Shield_180808/WiFi_Shield_180808/PDF/Assembly Guideline.PDF

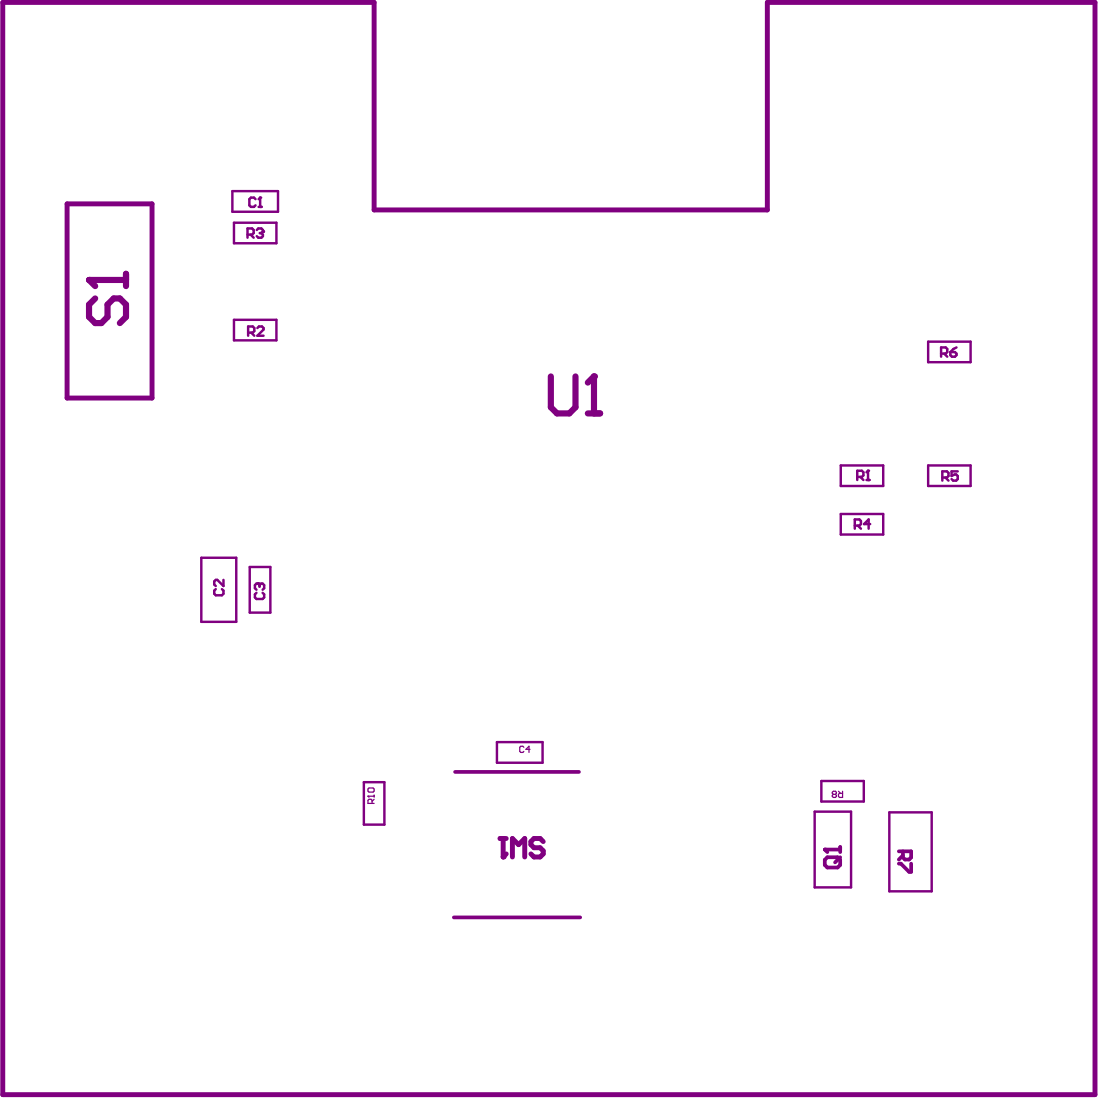
[picture p17: page 1]

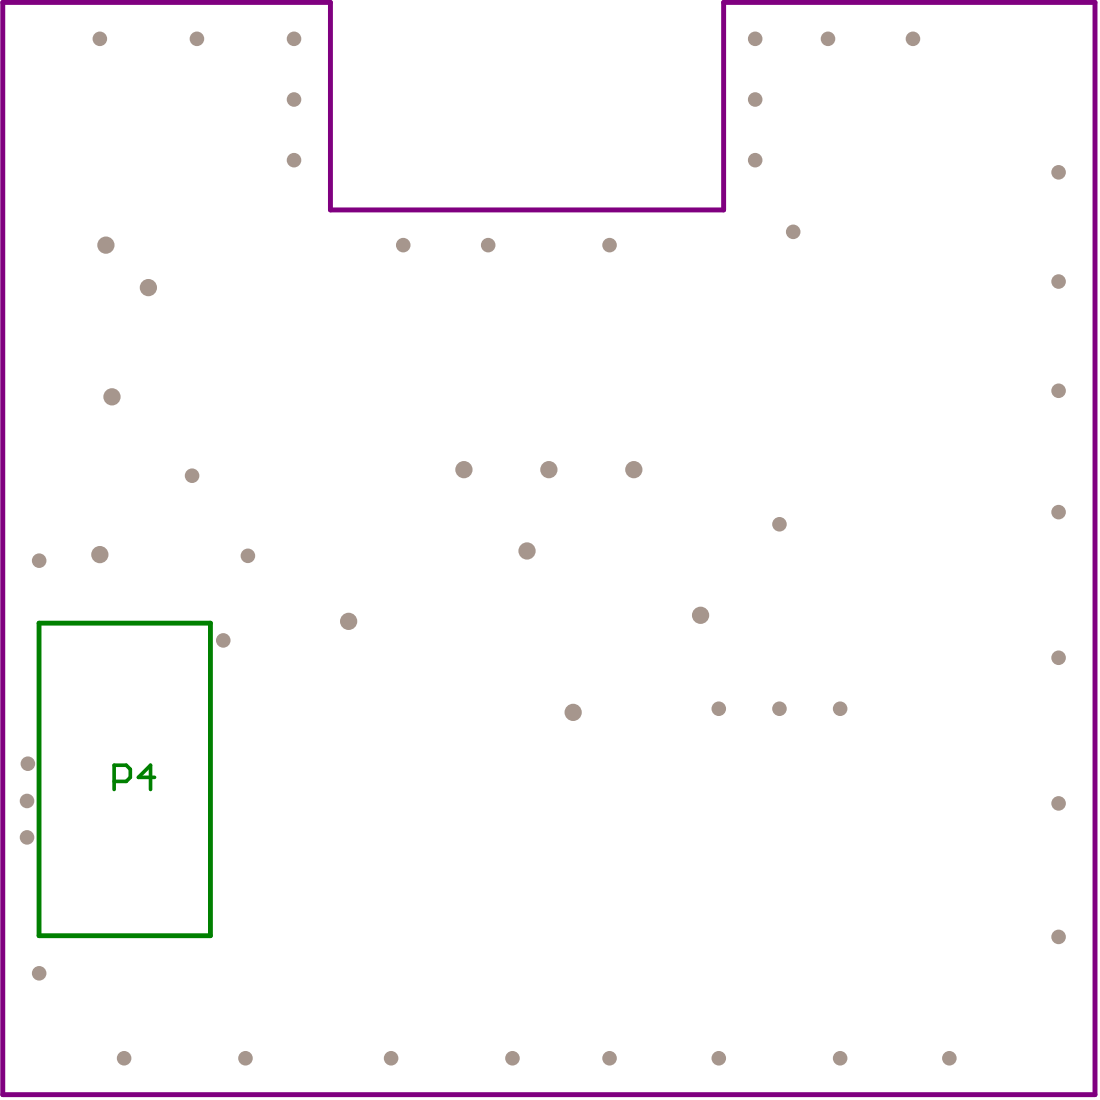
[picture p18: page 2]
