ducnguyen1224/HARD_WARE_SFAM/WiFi_Shield_180808/WiFi_Shield_180808/PDF/PCB 3D Print BOT.PDF

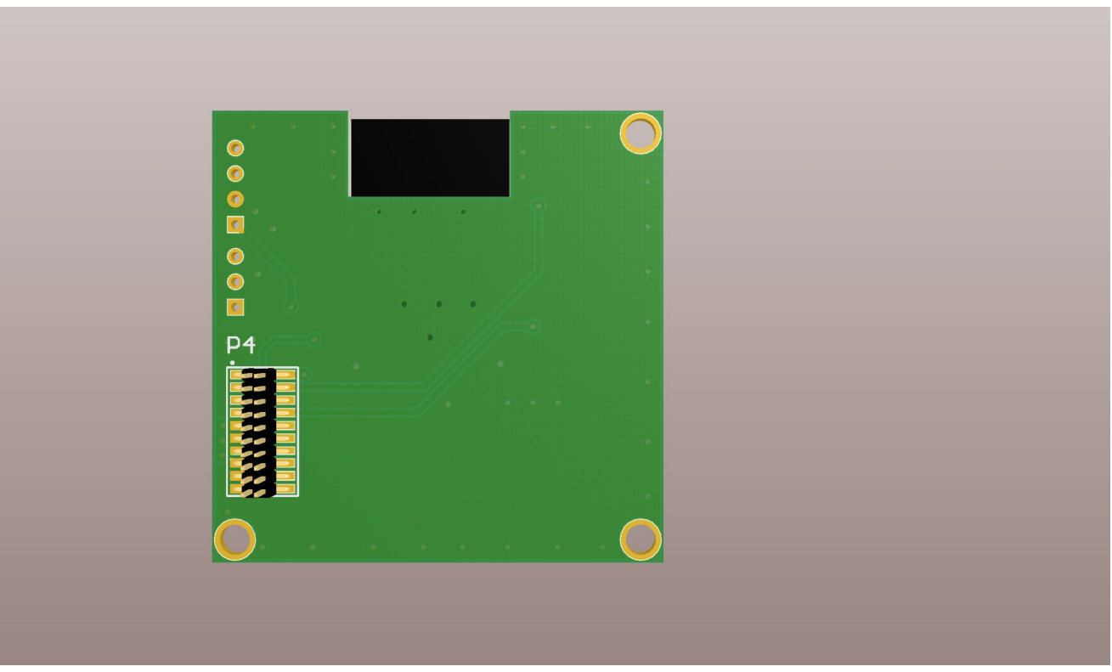
[picture p19: page 1]
