ducnguyen1224/HARD_WARE_SFAM/WiFi_Shield_180808/WiFi_Shield_180808/PDF/PCB 3D Print TOP.PDF

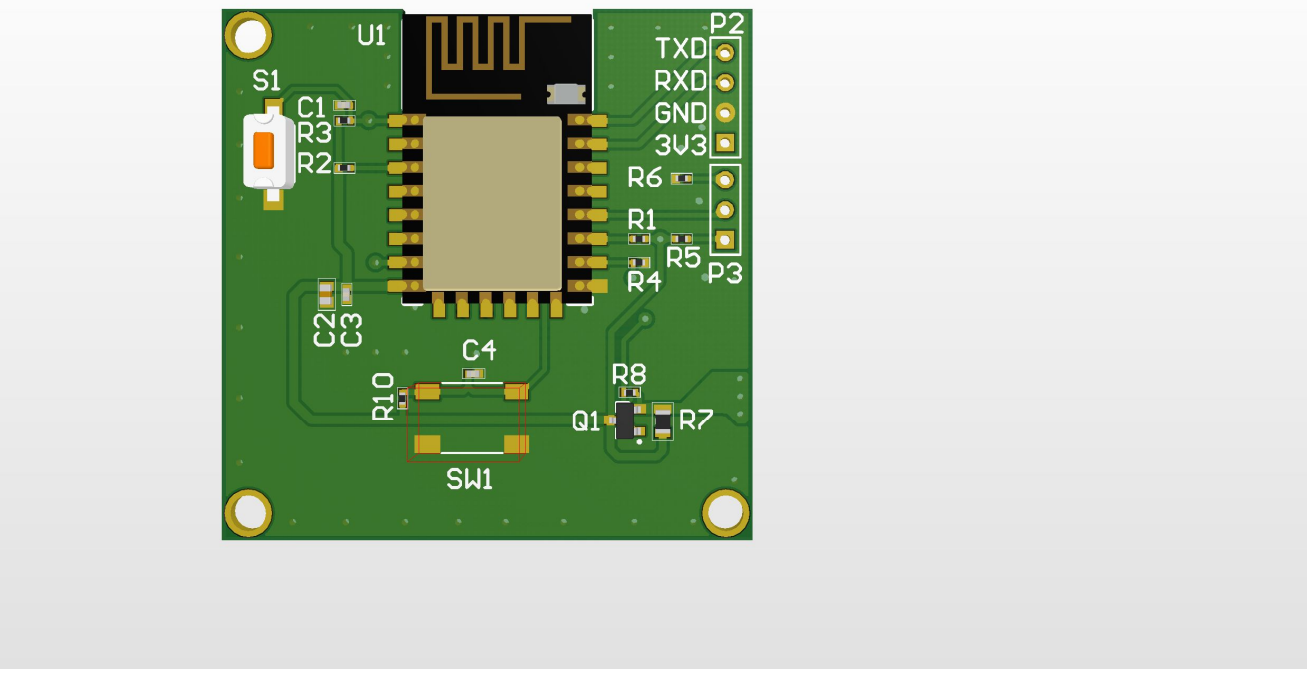
[picture p20: page 1]
