ducnguyen1224/HARD_WARE_SFAM/(list of files, drawings)

Other design files:
SensorNode_180808/DESIGN/SensorNode (8-8-2018 9-04-12 AM)/BLOCK DIAGRAM.SchDoc
SensorNode_180808/DESIGN/SensorNode (8-8-2018 9-04-12 AM)/CONNECTIVITY.SchDoc
SensorNode_180808/DESIGN/SensorNode (8-8-2018 9-04-12 AM)/MCU.SchDoc
SensorNode_180808/DESIGN/SensorNode (8-8-2018 9-04-12 AM)/POWER.SchDoc
SensorNode_180808/DESIGN/SensorNode (8-8-2018 9-04-12 AM)/SENSOR.SchDoc
SensorNode_180808/DESIGN/SensorNode (8-8-2018 9-04-12 AM)/SensorNode.PrjPcb
SensorNode_180808/DESIGN/SensorNode (8-8-2018 9-04-12 AM)/SFarm.PcbDoc
Sfarm _GW/Design/[02] BLOCK DIAGRAM.SchDoc
Sfarm _GW/Design/[03] POWER.SchDoc
Sfarm _GW/Design/[04] MCU.SchDoc
Sfarm _GW/Design/[05] Ethernet.SchDoc
Sfarm _GW/Design/[06] CONNECTIVITY.SchDoc
Sfarm _GW/Design/Sfarm.PrjPcb
Sfarm _GW/Design/SFarm.SchDoc
WiFi_Shield_180808/WiFi_Shield_180808/DESIGN/WiFi_Shield (8-8-2018 8-49-09 AM)/WiFi Shield Schematic.SchDoc
WiFi_Shield_180808/WiFi_Shield_180808/DESIGN/WiFi_Shield (8-8-2018 8-49-09 AM)/WiFi_Shield.PrjPcb
WiFi_Shield_180808/WiFi_Shield_180808/DESIGN/WiFi_Shield (8-8-2018 8-49-09 AM)/WiFi_Shield_PCB.PcbDoc
